TheRainstorm/FPGA-lightcube8/(commit log)

2021-12-21 完成Top, Display模块
2021-12-22 添加上位机串口发送python程序
    - 发现硬件最好是能根据串口发送速率来调整FPS
2021-12-22 添加串口接收模块
    - tb_uart_rx测试uart_rx正确性
2021-12-22 修改整体框架(时钟, FPS控制)
2021-12-24 添加顶层仿真
    - 修复一些错误
2021-12-24 添加n4ddr约束文件
2021-12-28 添加工程vivado工程文件
2021-12-28 添加vivado2019工程文件
2021-12-28 添加LED和7段数码管显示和top_wrap
2021-12-28 添加一些上板用测试
2021-12-29 重构代码
    - 添加显示静态帧模式
2021-12-29 添加同步信号
2021-12-29 修复一些问题
2021-12-29 修改test pmod
    - 手动控制某一面的LED灯
2021-12-29 vivado相关文件
2022-01-17 更新readme
